Clumsy-old-boy/ELS_Interface/jlcpcb/production_files/BOM-ELS_Interface.csv

Comment | Designator | Footprint | LCSC | Quantity
0R | R10,R11,R9 | R_0603_1608Metric | C21189 | 3
100R | R18,R4 | R_0402_1005Metric_Fixed | C25076 | 2
100nF | C2 | C_0603_1608Metric | C14663 | 1
100nf | C10,C11,C12,C13,C14,C15,C7,C8,C9 | C_0603_1608Metric | C14663 | 9
100uF 35V | C1 | CP_Elec_6.3x7.7 | C46550467 | 1
10k | R1 | R_0402_1005Metric_Fixed | C25744 | 1
10nF 50V | C4 | C_0805_2012Metric | C128911 | 1
10uF 50V | C6 | C_1206_3216Metric | C13585 | 1
1K | R3,R5,R6,R7,R8 | R_0402_1005Metric_Fixed | C11702 | 5
220R | R12,R13,R14 | R_0402_1005Metric_Fixed | C25091 | 3
220uF 6.3V | C5 | CP_EIA-3528-21_Kemet-B | C79111 | 1
22uF 25V | C3 | C_1210_3225Metric | C49118556 | 1
22uH | L1 | L_Bourns-SRN8040_8x8.15mm | C168163 | 1
3.24k | R2 | R_0402_1005Metric_Fixed | C3972407 | 1
4.7K | R15,R16,R17 | R_0402_1005Metric_Fixed | C25900 | 3
47R | R19 | R_0402_1005Metric_Fixed | C25118 | 1
D_Schottky | D4,D5 | D_SOD-123 | C8598 | 2
LED_0805_Green | LED1 | LED_0805_2012Metric | C2297 | 1
LED_0805_Red | LED2 | LED_0805_2012Metric | C84256 | 1
M24M01E-FMN6TP | IC1 | SOIC127P600X175-8N | C19654255 | 1
MF-MSMF110/16-2 | F1 | Fuse_1812_4532Metric_JLCPCB | C210834 | 1
PC817C | U3,U4,U5 | OPTO-SMD-4_L4.6-W6.5-P2.54-LS10.3-TL | C3025164 | 3
SMBJ15A | D1,D3 | D_SMB | C188412 | 2
SMD1812P050TF/30 | F2 | Fuse_1812_4532Metric_JLCPCB | C12559 | 1
SS34 | D2 | D_SMB | C908684 | 1
TPS5430DDAR | U1 | TI_SO-PowerPAD-8_ThermalVias_JLCPCB | C9864 | 1
TXB0104PWR | U2 | TSSOP-14_4.4x5mm_P0.65mm | C60708 | 1
