Clumsy-old-boy/ELS_Interface/docs/ELS_Interface_schematics.pdf

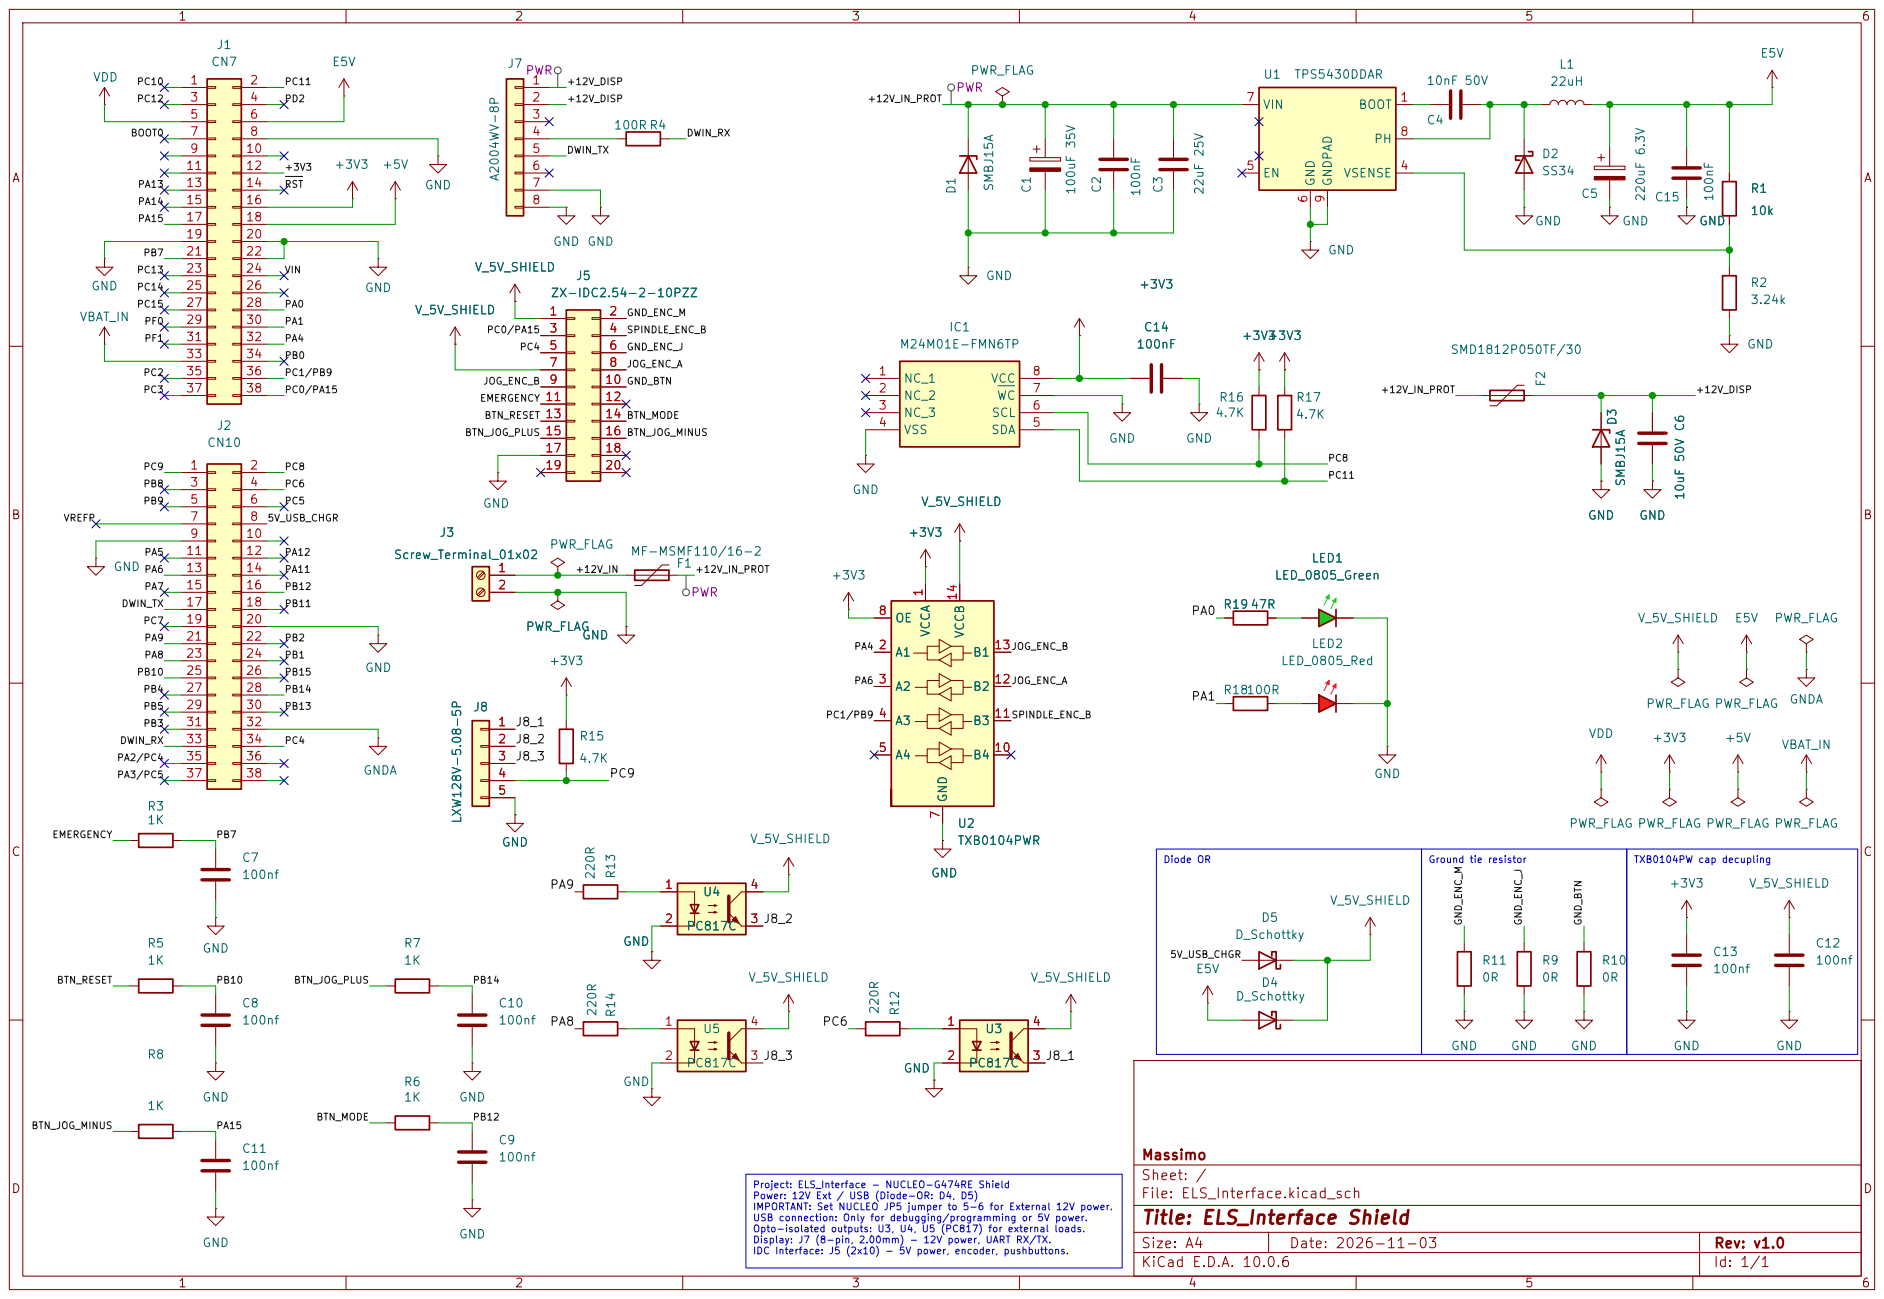
[picture p2: page 1]

IMPORTANT: Set NUCLEO JP5 jumper to 5-6 for External 12V power. USB connection: Only for debugging/programming or 5V power. Opto-isolated outputs: U3, U4, U5 (PC817) for external loads. Display: J7 (8-pin, 2.00mm) - 12V power, UART RX/TX.

Size: A4 | Rev: v1.0
KiCad E.D.A. 10.0.6 | Id: 1/1
