Clumsy-old-boy/ELS_Interface/docs/pcb.pdf

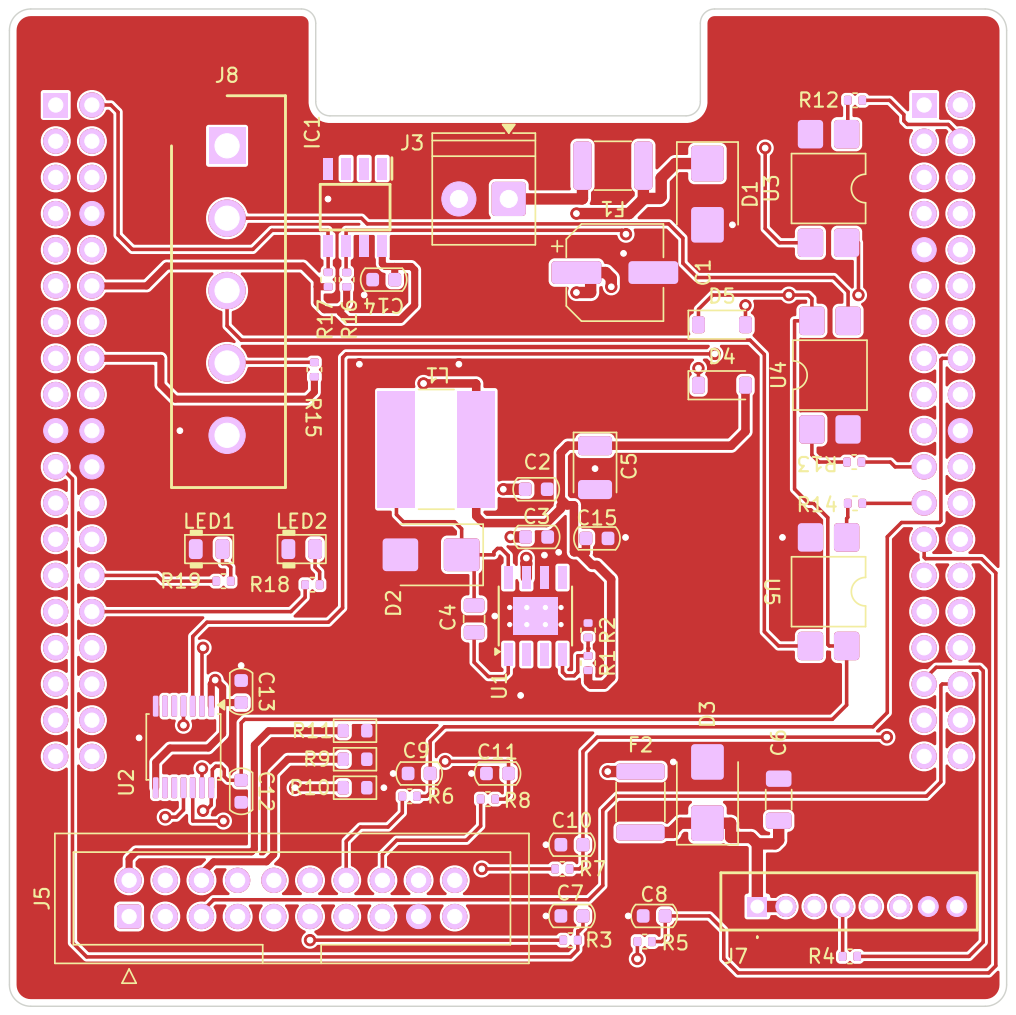
[picture p3: page 1]

Size: A4 | Date: | Rev:
KiCad E.D.A. 10.0.6 | | Id: 1/1

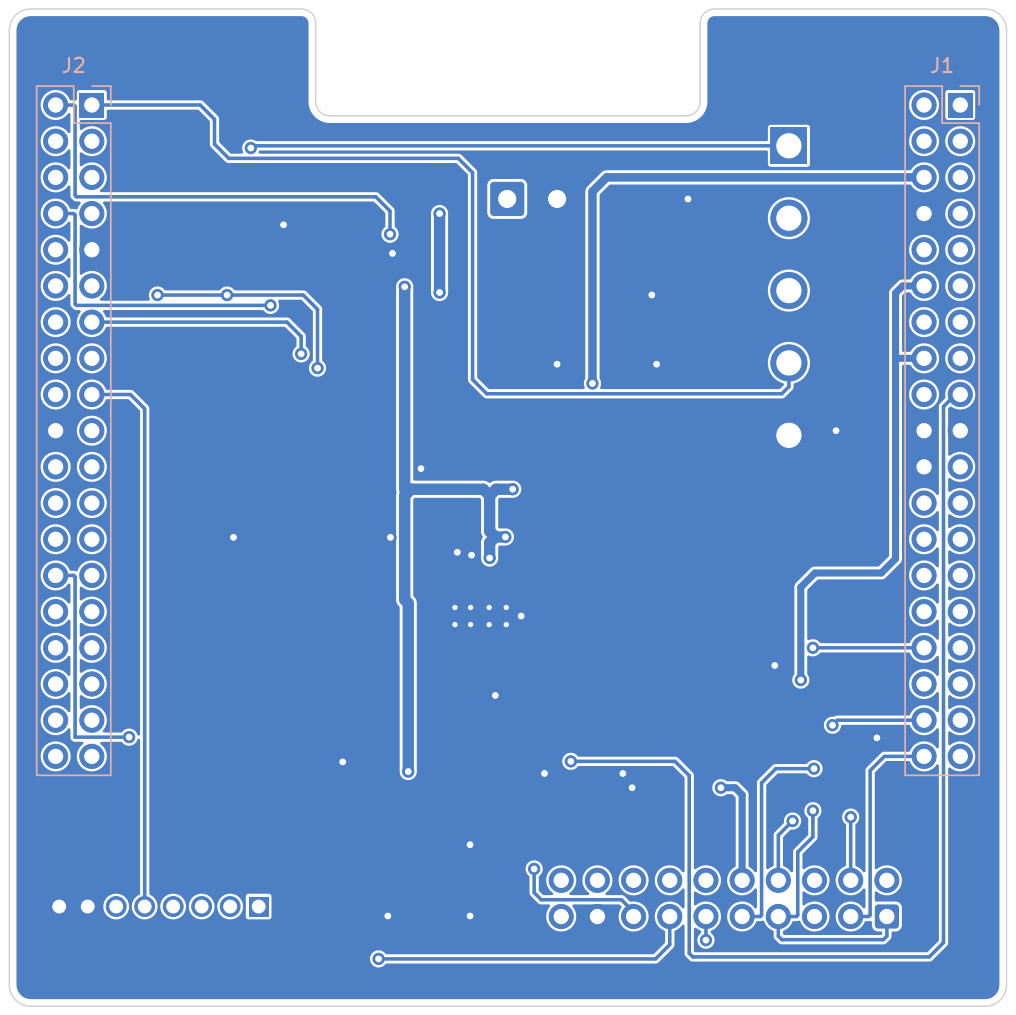
[picture p4: page 2]
