Clumsy-old-boy/ELS_Interface/ELS_Interface.kicad_pcb

## KiCad design ELS_Interface.kicad_pcb (2026-11-09)

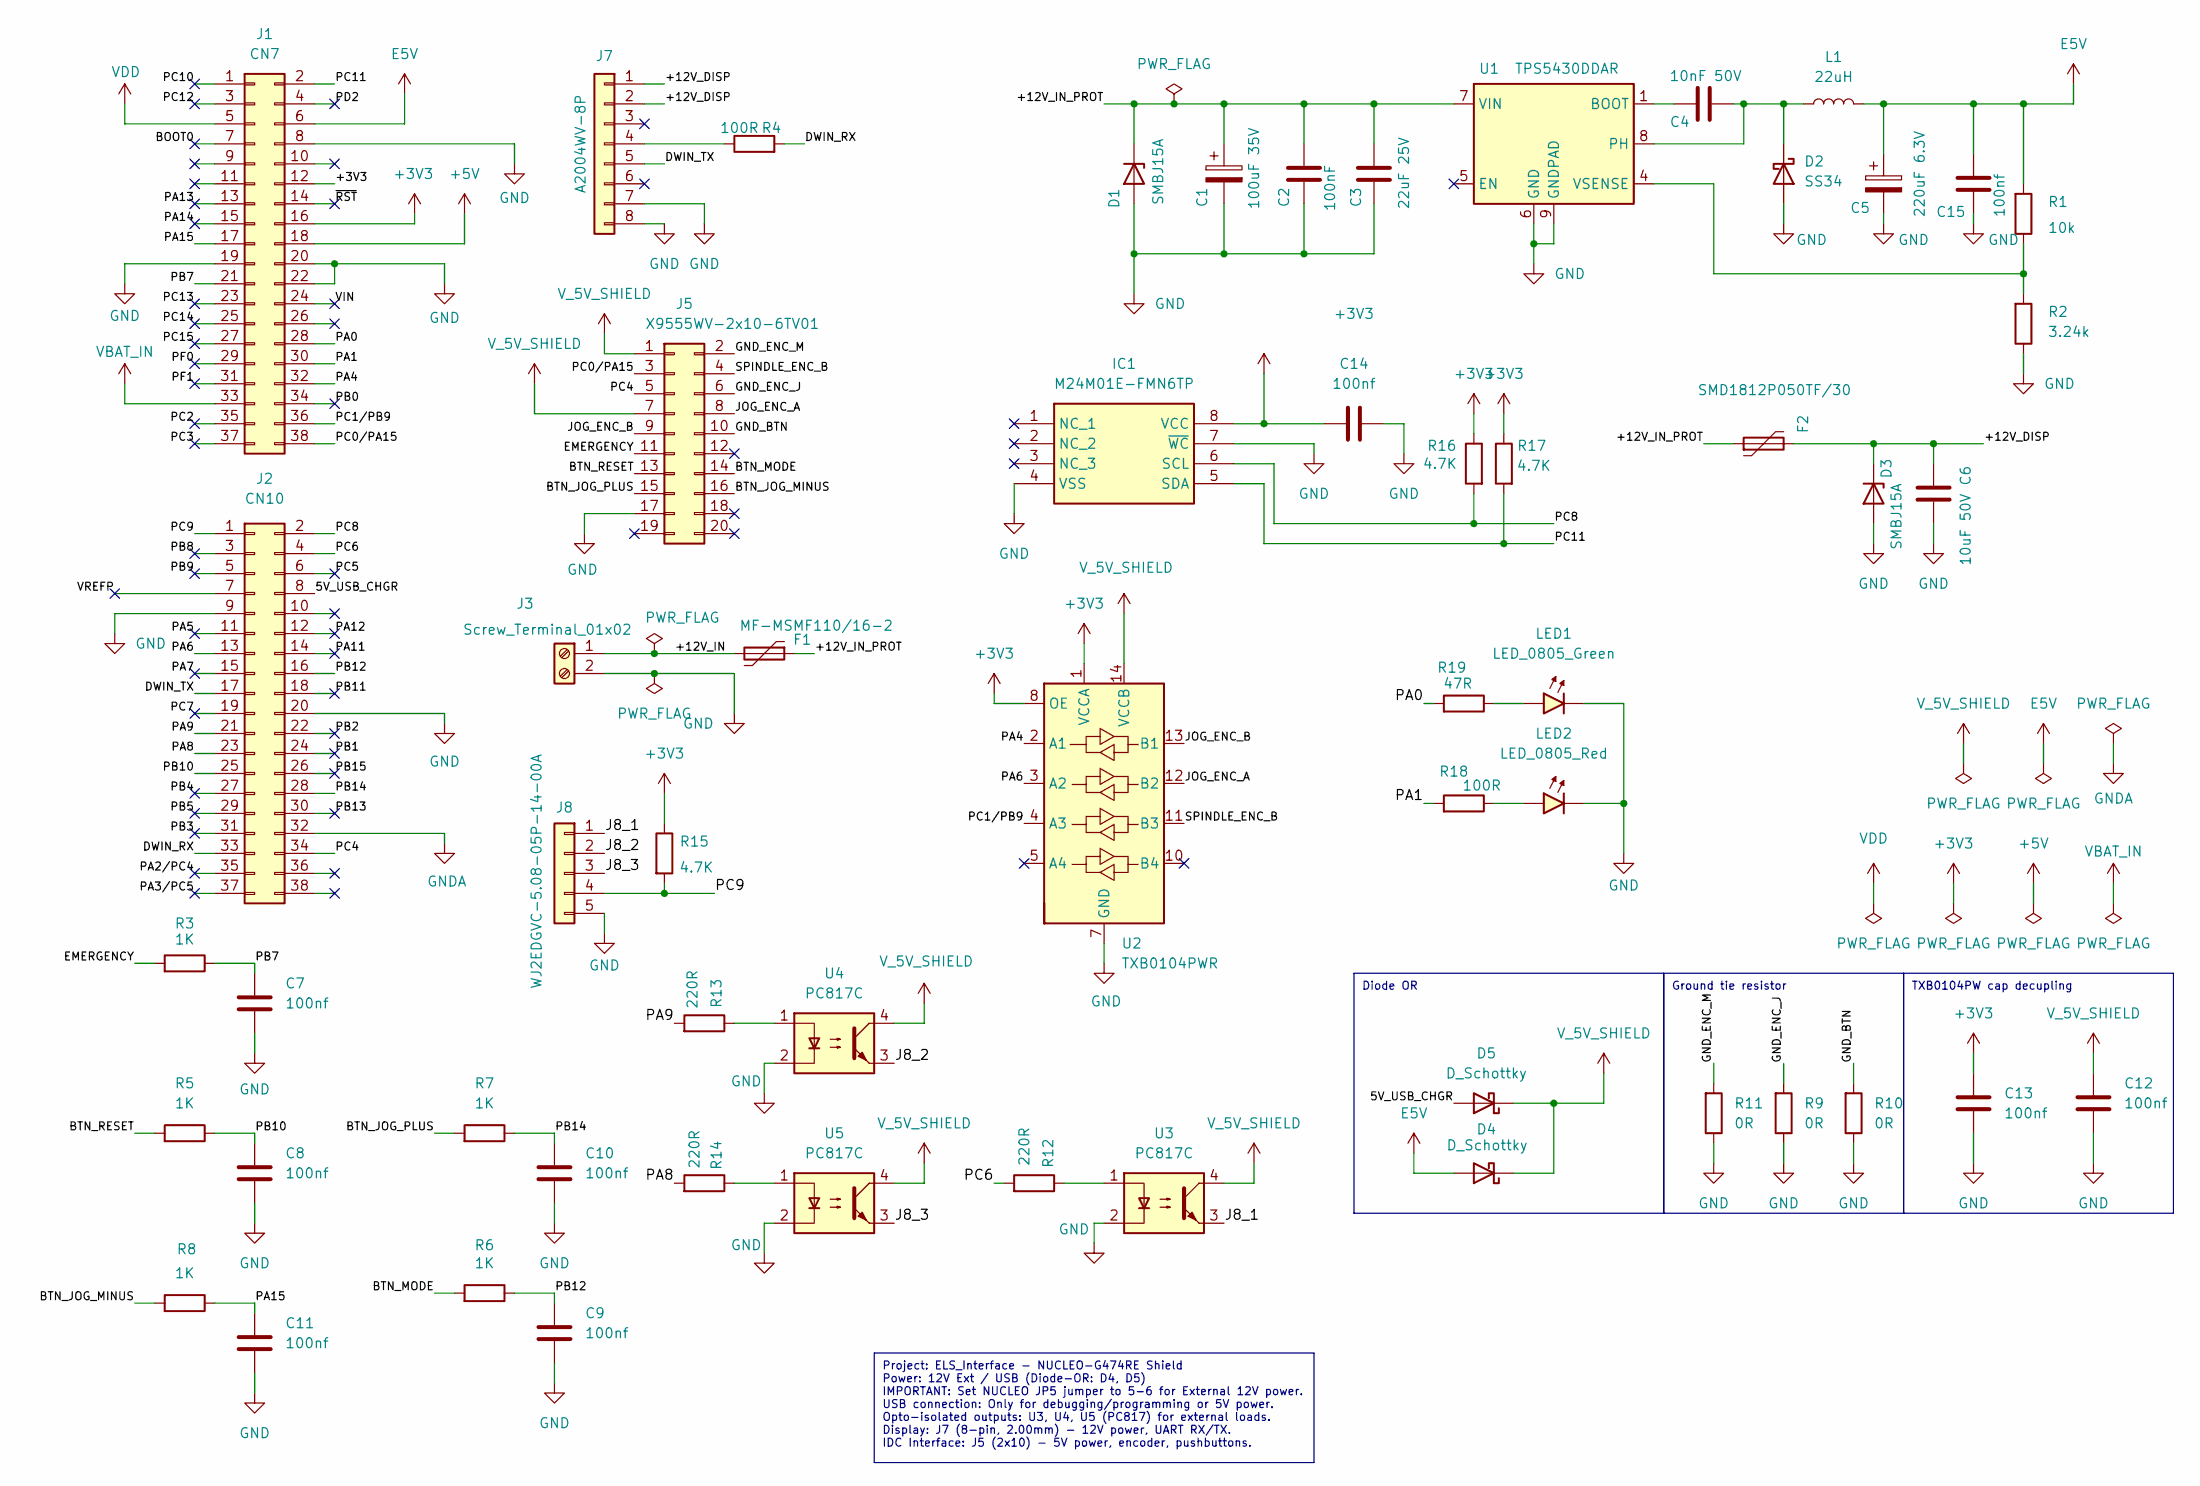
[picture p5: schematic ELS_Interface.kicad_sch, ELS_Interface Shield]

Parts:
C1: 100uF 35V; CP_Elec_6.3x7.7; MPN MA35V100M6X8; LCSC C46550467
C2: 100nF; C_0603_1608Metric; MPN CC0603KRX7R9BB104; LCSC C14663
C3: 22uF 25V; C_1210_3225Metric; MPN TCC1210X7R226K250MT; LCSC C49118556
C4: 10nF 50V; C_0805_2012Metric; MPN 08055C103KAT2A; LCSC C128911
C5: 220uF 6.3V; CP_EIA-3528-21_Kemet-B; MPN 6TPE220MAZB; LCSC C79111
C6: 10uF 50V; C_1206_3216Metric; MPN CL31A106KBHNNNE; LCSC C13585
C7, C8, C9, C10, C11, C12, C13, C14, C15: 100nf; C_0603_1608Metric; MPN CC0603KRX7R9BB104; LCSC C14663
D1, D3: SMBJ15A; D_SMB; MPN SMBJ15A; LCSC C188412
D2: SS34; D_SMB; MPN SS34; LCSC C908684
D4, D5: D_Schottky; D_SOD-123; LCSC C8598
F1: MF-MSMF110/16-2; Fuse_1812_4532Metric_JLCPCB; MPN MF-MSMF110/16-2; LCSC C210834
F2: SMD1812P050TF/30; Fuse_1812_4532Metric_JLCPCB; MPN SMD1812P050TF/30; LCSC C12559
IC1: M24M01E-FMN6TP; SOIC127P600X175-8N; Manufacturer_Part_Number M24M01E-FMN6TP; Mouser Part Number 511-M24M01E-FMN6TP
J1: CN7; PinSocket_2x19_P2.54mm_Vertical; MPN XDM254-2-19-Z-8.5-G0; LCSC C19268731
J2: CN10; PinSocket_2x19_P2.54mm_Vertical; MPN XDM254-2-19-Z-8.5-G0; LCSC C19268731
J3: Screw_Terminal_01x02; TerminalBlock_Phoenix_PT-1,5-2-3.5-H_1x02_P3.50mm_Horizontal; MPN DB125-3.5-2P-GN-S; LCSC C466970
J5: X9555WV-2x10-6TV01; IDC-Header_2x10_P2.54mm_Vertical; MPN X9555WV-2x10-6TV01; LCSC C2884550
J7: A2004WV-8P; CONN-TH_CNJMA2004WV-8P; MPN A2004WV-8P; LCSC C225246
J8: WJ2EDGVC-5.08-05P-14-00A; MPN WJ2EDGVC-5.08-05P-14-00A; LCSC C8423
L1: 22uH; L_Bourns-SRN8040_8x8.15mm; MPN FNR8065S220MT; LCSC C168163
LED1: LED_0805_Green; LED_0805_2012Metric; LCSC C2297
LED2: LED_0805_Red; LED_0805_2012Metric; LCSC C84256
R1: 10k; R_0402_1005Metric_Fixed; MPN 0402WGF1002TCE; LCSC C25744
R2: 3.24k; R_0402_1005Metric_Fixed; MPN CRCW04023K24FKED; LCSC C3972407
R3, R5, R6, R7, R8: 1K; R_0402_1005Metric_Fixed; MPN 0402WGF1001TCE; LCSC C11702
R4, R18: 100R; R_0402_1005Metric_Fixed; MPN 0402WGF1000TCE; LCSC C25076
R9, R10, R11: 0R; R_0603_1608Metric; MPN 0603WAF0000T5E; LCSC C21189
R12, R13, R14: 220R; R_0402_1005Metric_Fixed; MPN 0402WGF2200TCE; LCSC C25091
R15, R16, R17: 4.7K; R_0402_1005Metric_Fixed; MPN 0402WGF4701TCE; LCSC C25900
R19: 47R; R_0402_1005Metric_Fixed; MPN 0402WGF1000TCE; LCSC C25118
U1: TPS5430DDAR; TI_SO-PowerPAD-8_ThermalVias_JLCPCB; MPN TPS5430DDAR; LCSC C9864
U2: TXB0104PWR; TSSOP-14_4.4x5mm_P0.65mm; MPN TXB0104PWR; LCSC C60708
U3, U4, U5: PC817C; OPTO-SMD-4_L4.6-W6.5-P2.54-LS10.3-TL; MPN PC817C; LCSC C3025164

Connections:
+3V3: C13.1, C14.1, IC1.8 (VCC), J1.12, J1.16, R15.2, R16.2, R17.2, U2.1 (VCCA), U2.8 (OE)
+5V: J1.18
/5V_USB_CHGR: D5.2 (A), J2.8
/+12V_DISP: C6.1, D3.1 (K), F2.2, J7.1, J7.2
/+12V_IN: F1.2, J3.1
/+12V_IN_PROT: C1.1, C2.1, C3.1, D1.1 (K), F1.1, F2.1, U1.7 (VIN)
/BOOT0: J1.7
/BTN_JOG_MINUS: J5.16, R8.1
/BTN_JOG_PLUS: J5.15, R7.1
/BTN_MODE: J5.14, R6.1
/BTN_RESET: J5.13, R5.1
/DWIN_RX: J2.33, R4.1
/DWIN_TX: J2.17, J7.5
/EMERGENCY: J5.11, R3.1
/GND_BTN: J5.10, R10.1
/GND_ENC_J: J5.6, R9.1
/GND_ENC_M: J5.2, R11.1
/J8_1: J8.1, U3.3
/J8_2: J8.2, U4.3
/J8_3: J8.3, U5.3
/JOG_ENC_A: J5.8, U2.12 (B2)
/JOG_ENC_B: J5.9, U2.13 (B1)
/PA0: J1.28, R19.1
/PA1: J1.30, R18.1
/PA2/PC4: J2.35
/PA3/PC5: J2.37
/PA4: J1.32, U2.2 (A1)
/PA5: J2.11
/PA6: J2.13, U2.3 (A2)
/PA7: J2.15
/PA8: J2.23, R14.1
/PA9: J2.21, R13.1
/PA11: J2.14
/PA12: J2.12
/PA13: J1.13
/PA14: J1.15
/PA15: C11.1, J1.17, R8.2
/PB0: J1.34
/PB1: J2.24
/PB2: J2.22
/PB3: J2.31
/PB4: J2.27
/PB5: J2.29
/PB7: C7.1, J1.21, R3.2
/PB8: J2.3
/PB9: J2.5
/PB10: C8.1, J2.25, R5.2
/PB11: J2.18
/PB12: C9.1, J2.16, R6.2
/PB13: J2.30
/PB14: C10.1, J2.28, R7.2
/PB15: J2.26
/PC0/PA15: J1.38, J5.3
/PC1/PB9: J1.36, U2.4 (A3)
/PC2: J1.35
/PC3: J1.37
/PC4: J2.34, J5.5
/PC5: J2.6
/PC6: J2.4, R12.1
/PC7: J2.19
/PC8: IC1.6 (SCL), J2.2, R16.1
/PC9: J2.1, J8.4, R15.1
/PC10: J1.1
/PC11: IC1.5 (SDA), J1.2, R17.1
/PC12: J1.3
/PC13: J1.23
/PC14: J1.25
/PC15: J1.27
/PD2: J1.4
/PF0: J1.29
/PF1: J1.31
/SPINDLE_ENC_B: J5.4, U2.11 (B3)
/VIN: J1.24
/VREFP: J2.7
/~RST: J1.14
E5V: C5.1, C15.1, D4.2 (A), J1.6, L1.2, R1.1
GND: C1.2, C2.2, C3.2, C5.2, C6.2, C7.2, C8.2, C9.2, C10.2, C11.2, C12.2, C13.2, C14.2, C15.2, D1.2 (A), D2.2 (A), D3.2 (A), IC1.4 (VSS), IC1.7 (~WC), J1.8, J1.19, J1.20, J1.22, J2.9, J2.20, J3.2, J5.17, J7.7, J7.8, J8.5, LED1.1 (K), LED2.1 (K), R2.2, R9.2, R10.2, R11.2, U1.6 (GND), U1.9 (GNDPAD), U2.7 (GND), U3.2, U4.2, U5.2
GNDA: J2.32
unnamed: C4.2, D2.1 (K), L1.1, U1.8 (PH)
unnamed: J7.4, R4.2
unnamed: LED1.2 (A), R19.2
unnamed: LED2.2 (A), R18.2
unnamed: R12.2, U3.1
unnamed: R13.2, U4.1
unnamed: R14.2, U5.1
unnamed: C4.1, U1.1 (BOOT)
unnamed: R1.2, R2.1, U1.4 (VSENSE)
VBAT_IN: J1.33
VDD: J1.5
V_5V_SHIELD: C12.1, D4.1 (K), D5.1 (K), J5.1, J5.7, U2.14 (VCCB), U3.4, U4.4, U5.4

Notes on the sheet:
Project: ELS_Interface - NUCLEO-G474RE Shield Power: 12V Ext / USB (Diode-OR: D4, D5) IMPORTANT: Set NUCLEO JP5 jumper to 5-6 for External 12V power. USB connection: Only for debugging/programming or 5V power. Opto-isolated outputs: U3, U4, U5 (PC817) for external loads. Display: J7 (8-pin, 2.00mm)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
Diode OR
TXB0104PW cap decupling
Ground tie resistor

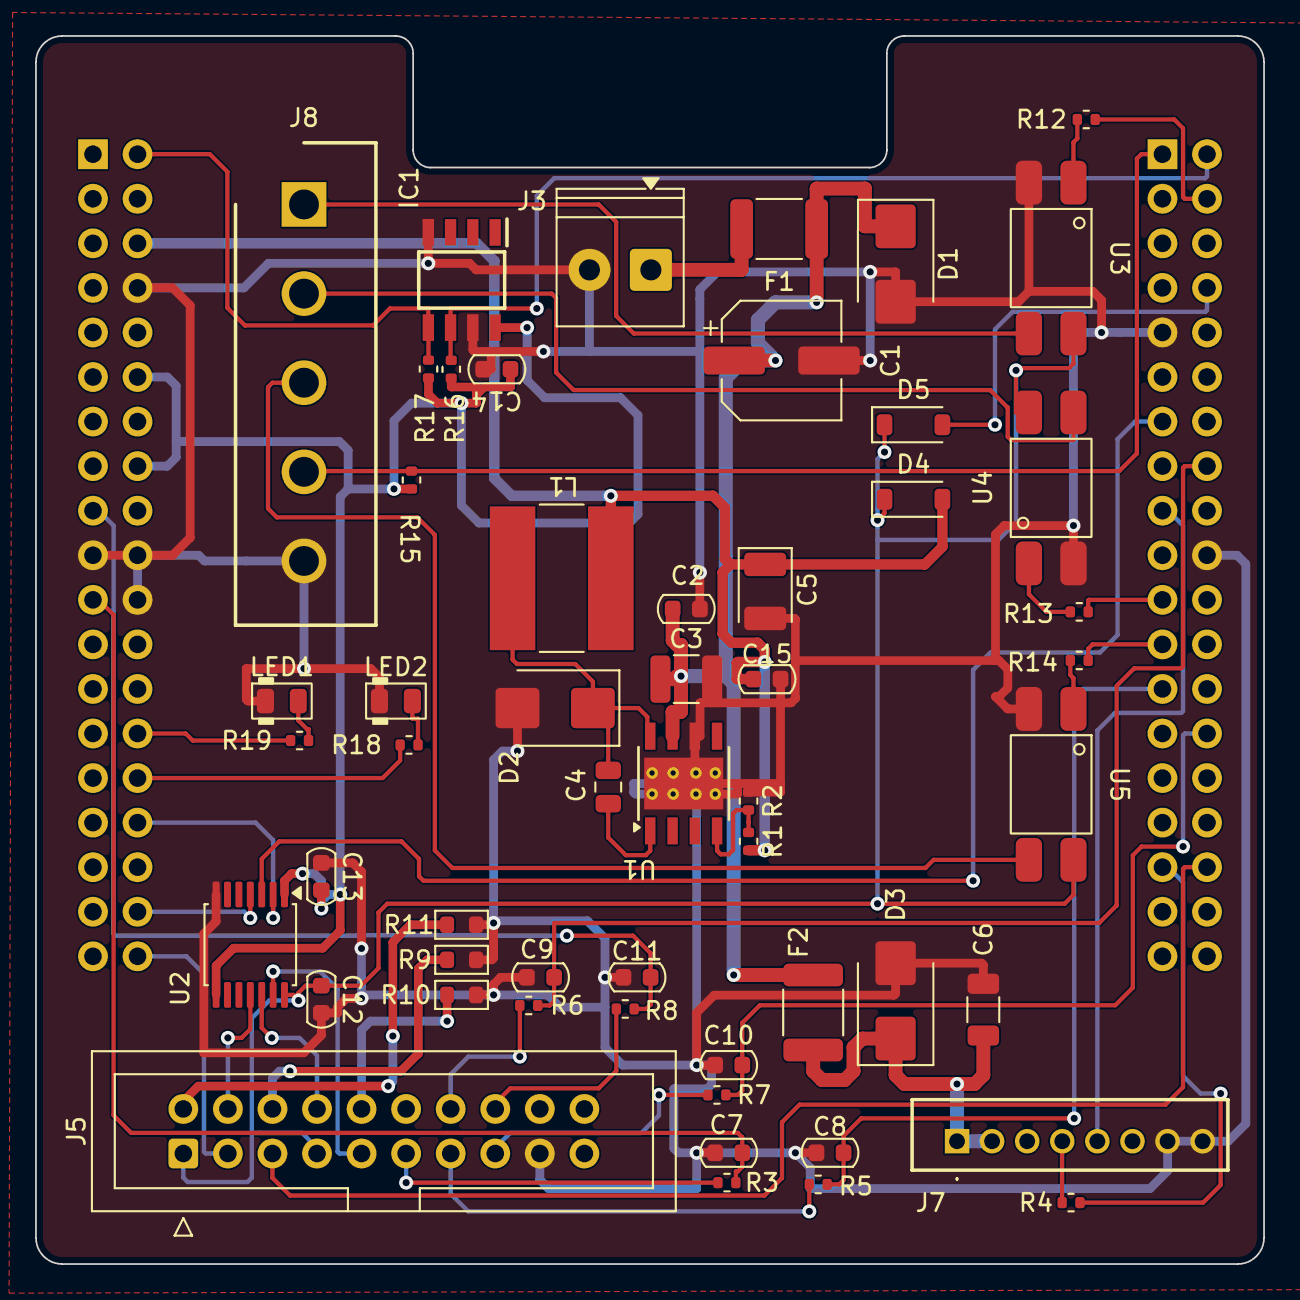
[picture p6: board ELS_Interface.kicad_pcb from above]

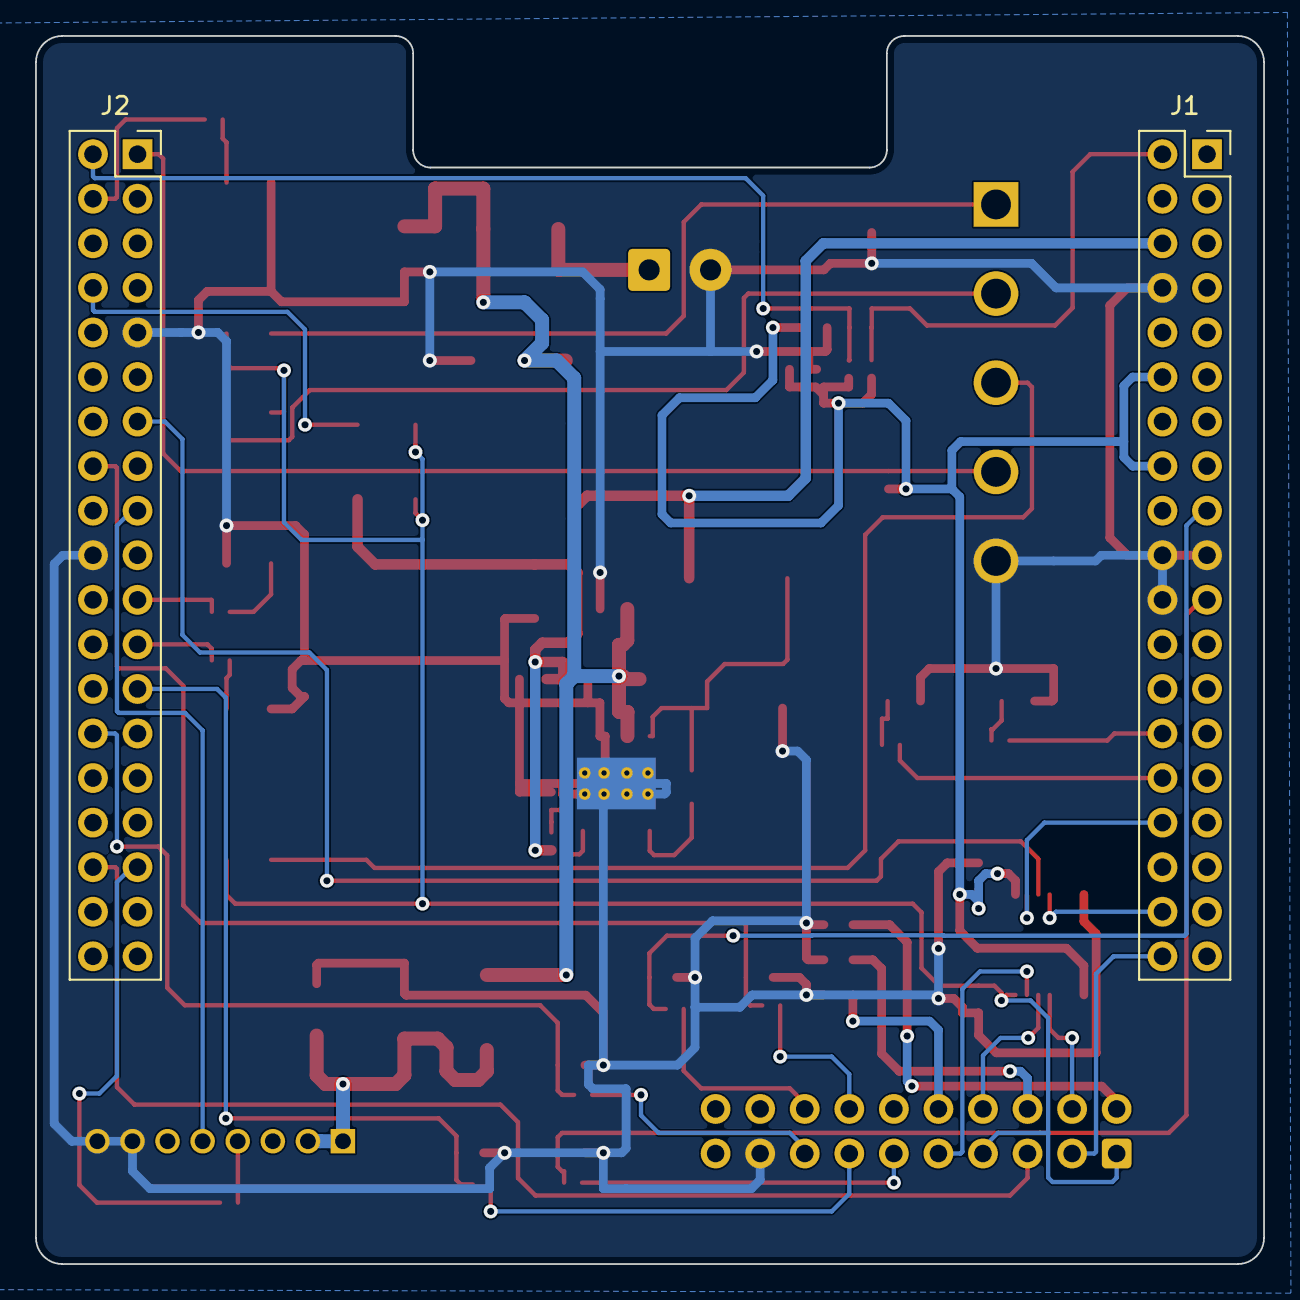
[picture p7: board ELS_Interface.kicad_pcb from below]

Board: 2 copper layers, 70.0 x 70.0 mm, 56 parts (2 on the bottom side), 51 nets.
