Clumsy-old-boy/ELS_Interface/(commit log)

2026-11-06 ELS_Interface: NUCLEO-G474RE shield, KiCad 10 (ERC/DRC clean)
    [BOM-ELS_Interface.csv, ELS_Interface.kicad_pcb, ELS_Interface.kicad_sch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]
2026-11-06 hw: regenerated production files, aligned KiCad project and project library
    [ELS_Interface.kicad_pcb, ELS_Interface.kicad_sch]
2026-11-07 sch: connector LCSC codes aligned with the verified cart (J1/J2/J5/J8); mating parts recorded
    [ELS_Interface.kicad_sch]
2026-11-07 docs: correct R15/PB7 emergency wiring, confirm I2C3 on PC8/PC11, record the 3 excluded DRC findings, fix prerequisite table header
2026-11-07 docs: add PCB layout PDF (top with 55 refdes, bottom with J1/J2) and link it; regenerate USAGE, CONFIGURATION and TEST_PROCEDURE PDFs
2026-11-09 Update ELS_Interface to 2026-11-09 state (LCSC validation)
    - Replaced 7 files: 3 KiCad (2026-11-09 state), 3 production (BOM, CPL, GERBER), 1 library (ELS_Custom.kicad_sym)
    - No new files added
    - Cleanup of the workspace (28 files + 2 folders) stays local
    [BOM-ELS_Interface.csv, ELS_Interface.kicad_pcb, ELS_Interface.kicad_sch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]
2026-11-09 Add 4 custom footprints used by LCSC validation
    - C_1210_3225Metric (C3), Fuse_1812_4532Metric_JLCPCB (F1/F2), OPTO-SMD-4_L4.6-W6.5-P2.54-LS10.3-TL (U3/U4/U5), TI_SO-PowerPAD-8_ThermalVias_JLCPCB (U1)
    - Referenced by the PCB updated in the previous commit: without them a clone cannot rebuild the board
2026-11-09 Connector footprints: 3D models from absolute path to KIPRJMOD
    - CONN-TH_CNJMA2004WV-8P: 53014-0810.stp
    - WJ2EDGVC-5.08-05P-14-00A: WJ2EDGVC-5.08-5P.stp
    - Both models were already in library/3d/: the project is now portable (no paths outside the repository)
